javnson/GMP_H503_Peripheral_DBGer/模组介绍_v2.md

## GMP Peripheral ISO Host 工业级多总线通用转USB聚合模组

> **告别反复改版，一块板卡搞定任意现场接口！**
>
> 专为工业边缘计算、数据汇总压缩与智能网关量身打造的“万能外设桥接中枢”。

### 【行业痛点与破局之道】

在工业物联网（IIoT）与边缘数据采集项目中，现场设备协议繁多、甲方接口定义迟迟不明确、研发周期紧迫是团队常面临的困境。

**GMP Peripheral ISO Host** 应运而生——凭借强大的硬件多协议原生支持、灵活的可编程逻辑扩展、标准 Arduino 机械尺寸，以及**全套命令行（CLI）与 AI Agent Skill 工具链**，只需将其作为子卡嵌入到您的“信号汇总与压缩上传模组”中，即可轻松应对几乎所有常见工业现场与传感器接口。无论是工程师手动调试，还是交由 AI 自动巡检适配，都能以极致灵活性彻底终结接口不确定的困扰！

### 【核心产品亮点】

#### 1. 澎湃算力与工业全总线大满贯

- **高性能核心架构**：搭载全新 **高性能 ARM Cortex-M33 核心（STM32H5 系列）**，主频高达 250MHz，提供充沛的实时调度与数据预处理能力。   
- **全栈工业通信**：原生集成 **CAN / CAN-FD、RS-485、RS-232、UART** 等主流现场工业总线，板载终结电阻与工业级防护。   
- **高速板级与传感器总线**：全面覆盖 **SPI、I2C**，并前瞻性支持下一代超高速双线总线 **I3C**。   
- **运动控制与精密模拟量**：原生引出 **QEP 正交编码器接口**（带专用电平缓冲保护），以及多路 **高精度 ADC 采集** 与 **DAC 模拟输出**、通用 GPIO。   

#### 2. 独创 TPLD 硬件级可编程逻辑扩展

- **硬件级实时响应**：板载微型可编程逻辑器件（TPLD），在 MCU 之外扩展出 **7 路高灵活性可编程 I/O**。   
- **专用时钟与边沿捕获**：配备专用 SMA / RF 接口的时钟与高速边沿捕获通道（Edge Capture），轻松实现纳秒级精确时间戳标记、脉冲测频或硬件级连锁保护，让边缘采集具备硬件确定性。   

#### 3. 坚如磐石的工业级全电气隔离

- **前后端完全电气隔离**：采用专业数字隔离芯片与一体化隔离 DC-DC 稳压电源模块，将现场端（各类工业总线/模拟量）与上位机 USB 端彻底隔绝，耐受恶劣工况下的共模干扰、地环路电位差与电涌瞬变。   
- **多级 ESD 与浪涌抑制**：所有对外接口均重度布置专用瞬态抑制器（TVS/ESD Array），保障工业现场 7×24 小时连续无故障运行。   

#### 4. 全方位软件生态：GUI · 脚本级 CLI · AI Agent/Skill 深度接入

- **USB-HID 免驱架构**：下位机采用标准 USB-HID 协议通信，Windows / Linux / 工控机环境即插即用，无需安装第三方驱动。
- **专业可视化上位机**：配套专属图形化交互软件，支持一键配置总线参数、寄存器读写、波形实时监视与数据转发。
- **脚本化 CLI 命令行工具**：提供轻量高效的命令行控制台与 API，支持自动化测试脚本（Python / Shell 等）无缝调用与流水线批量操作。
- **AI-Ready / Agent Skill 原生赋能**：**配套专用的 AI Tool/Skill 接口**！可直接作为大模型智能体（AI Agent）的外设感知与执行端。开发人员只需输入自然语言（例如*“读取 RS485 地址为 0x02 的温湿度计数据并绘制波形”*或*“尝试用 500k 波特率探测 CAN 总线上有哪些在线节点”*），AI 即可调用板卡工具链自动完成总线参数协商、指令下发、通信调试、协议解析与现场部署，将调试效率推向智能化新高度！

#### 5. 标准化模块尺寸，极简嵌入

- **Arduino 标准外形尺寸**：结构紧凑，既可作为开发调试阶段的万能多功能探针，又能直接以标准子卡形态堆叠嵌入到客户的信号压缩与上网终端中，量产部署无缝衔接。   

### 【技术规格一览】

| **类别** | **规格参数** |
| --- | --- |
| **主控芯片** | STM32H503CBU6 (ARM Cortex-M33 @ 250MHz) |
| **主机接口** | Type-C USB (USB-HID 免驱，支持 USB 电气隔离) |
| **隔离性能** | 隔离 DC-DC 供电 + 高速数字隔离器全通道隔离 |
| **工业串行总线** | 1× CAN/CAN-FD、1× RS-485、1× RS-232、1× 独立 UART |
| **同步/传感器接口** | 1× 高速 SPI、1× I2C（带上拉选择）、1× I3C |
| **运动与模拟量** | 3通道 QEP 编码器输入 (A/B/Index)、多路 ADC 采样、多路 DAC 输出 |
| **可编程逻辑扩展**  | TPLD 扩展：7路自由可编程 I/O + 1路高速边沿捕获/时钟输入 (SMA接口) |
| **接口防护** | 端口全覆盖 ESD / TVS 阵列及总线级瞬变抑制保护 |
| **外形结构** | 标准 Arduino 尺寸，预留多组标准间距排针与安装定位孔 |

### 【适用场景】

- **工业边缘网关 / 数据压缩上传终端**：无需定制专用底板，快速汇总现场变频器、PLC、传感器及电表数据。
- **接口未定项目的快速验证**：为项目研发提供强大的“缓冲带”，无论客户最终敲定何种总线，底层硬件均可即刻响应。
- **实验室多功能调试神器**：工程师工作台常备的万能通信调试器、信号分析与工业总线转接利器。
- **AI 驱动的自动化调试与测试系统**：将现场总线直接接入 AI 大模型链路，由 AI 全自动完成传感器接入排查、波特率自适应嗅探与固件自动化回归测试。
