javnson/GMP_H503_Peripheral_DBGer/cpld/led_direct/configuration_summary.pdf

# Configuration Summary

# TPLD2001DGSR

# Version: 1.8.0+1529

# Date Created: 10/12/2026

## This document is to provide information related to the design. The information available in this document is an image of the schematic, an estimation of power consumed, an

input and output table, a set of tables indicating how the blocks are configured,

## frequencies propogating through the device, and the hex code that was pushed into registers. For general device information such as electrical characteristics refer to the

datasheet.

## Summary

## Schematic Diagram

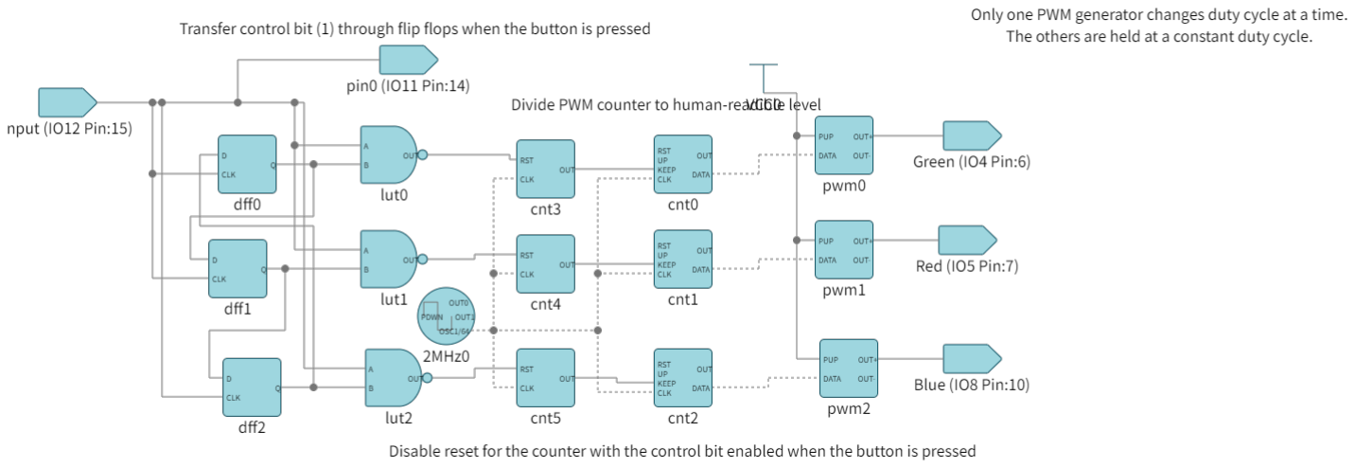
[picture p1: figure]

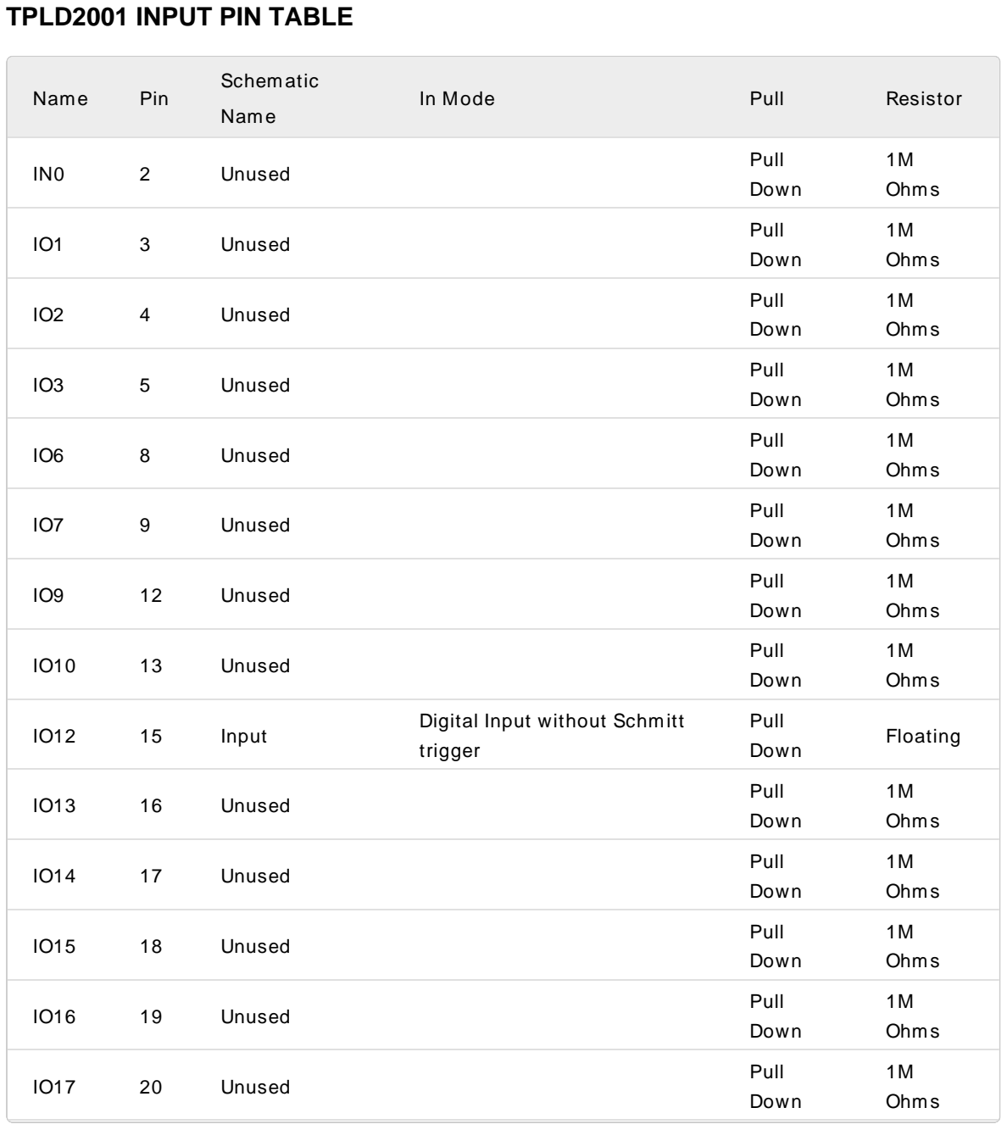
[picture p2: figure]
Name; Pin; Schematic; In Mode; Pull; Resistor; Unused; Pull Down; 1M Ohms; Input; Digital Input without Schmitt trigger; Floating; TPLD2001 INPUT PIN TABLE

## TPLD2001 OUTPUT PIN TABLE

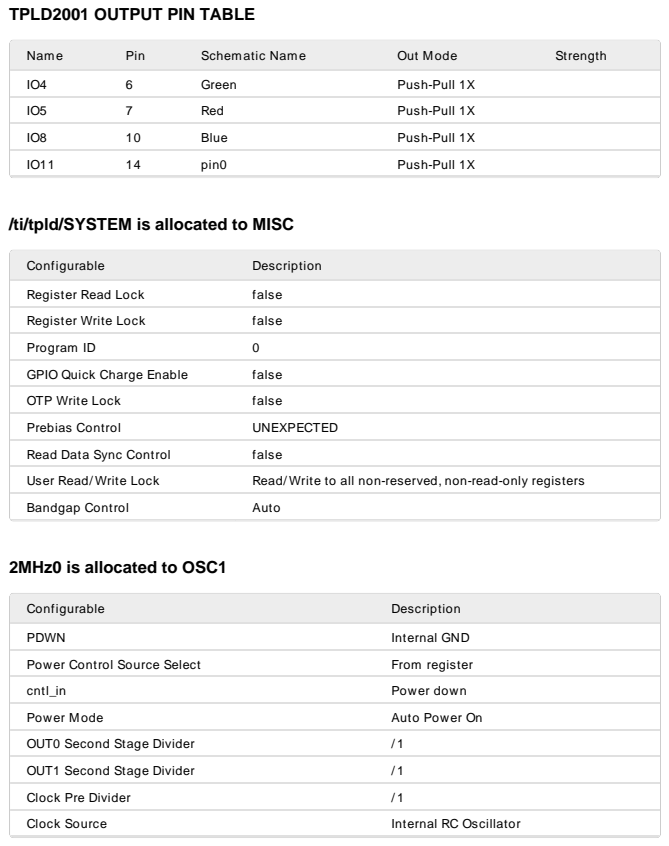
[picture p3: page 4]

/ti/tpld/SYSTEM is allocated to MISC

Configurable | Description
IN | pwm2.OUT0
in_ctl | Digital Input without Schmitt trigger
Output Mode | Push-Pull 1X
Pull | Pull Down
Pull Up/ Down Resistor Value | Floating
Configurable | Description
CLK | 2MHz0.OSC1/ 64
IN | Internal GND
KEEP | cnt3
UP | Internal GND
Initial Value | Bypass initial
Output Polarity | Non-inverted
Control Data | 255
KEEP Sync Bypass | 2-DFF sync
RST Sync Bypass | 2-DFF sync
UP Sync Bypass | 2-DFF sync

## Blue is allocated to IO8

## cnt0 is allocated to CNT6_FSM0

Configurable | Description
CLK | 2MHz0.OSC1/ 64
IN | Internal GND
KEEP | cnt4
UP | Internal GND
Initial Value | Bypass initial
Output Polarity | Non-inverted
Control Data | 255
KEEP Sync Bypass | 2-DFF sync
RST Sync Bypass | 2-DFF sync
UP Sync Bypass | 2-DFF sync
Configurable | Description
CLK | 2MHz0.OSC1/ 64
IN | Internal GND
KEEP | cnt5
UP | Internal GND
Initial Value | Bypass initial
Output Polarity | Non-inverted
Control Data | 255
KEEP Sync Bypass | 2-DFF sync
RST Sync Bypass | 2-DFF sync
UP Sync Bypass | 2-DFF sync

## cnt1 is allocated to CNT7_FSM1

## cnt2 is allocated to CNT8_FSM2

## cnt3 is allocated to LUT3_10

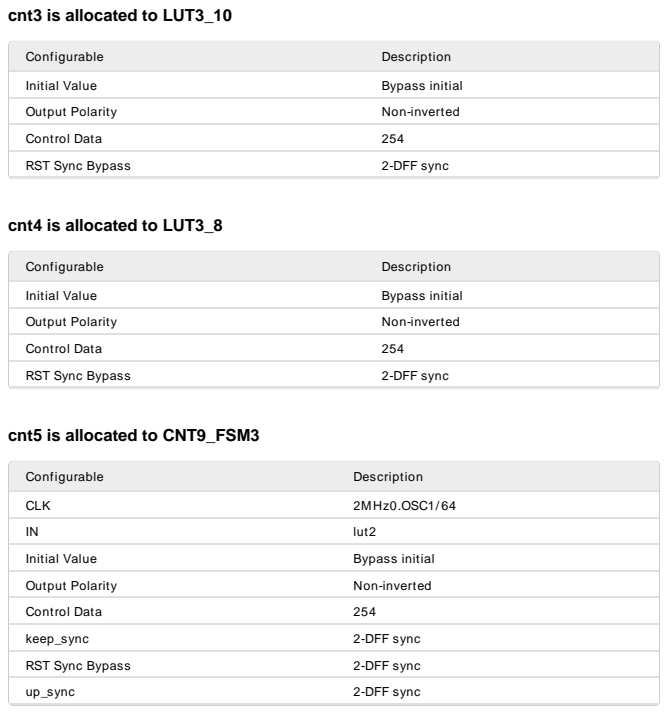
[picture p4: page 7]

## dff0 is allocated to LUT2_2

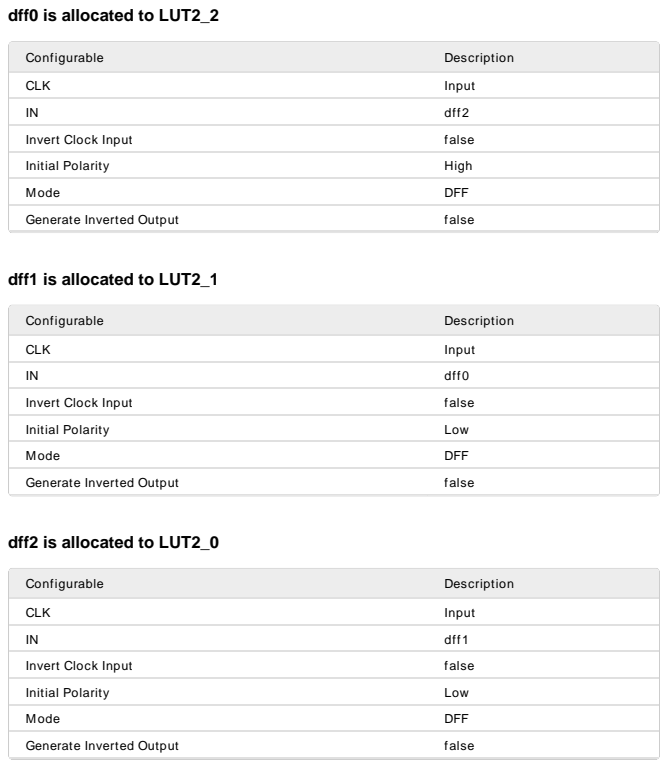
[picture p5: page 8]

## Green is allocated to IO4

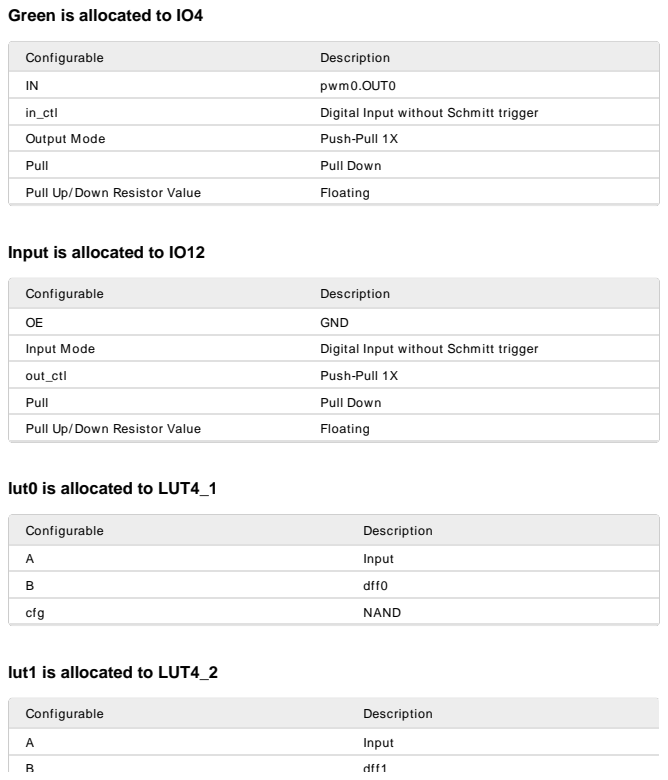
[picture p6: page 9]

Input is allocated to IO12

## lut2 is allocated to LUT4_3

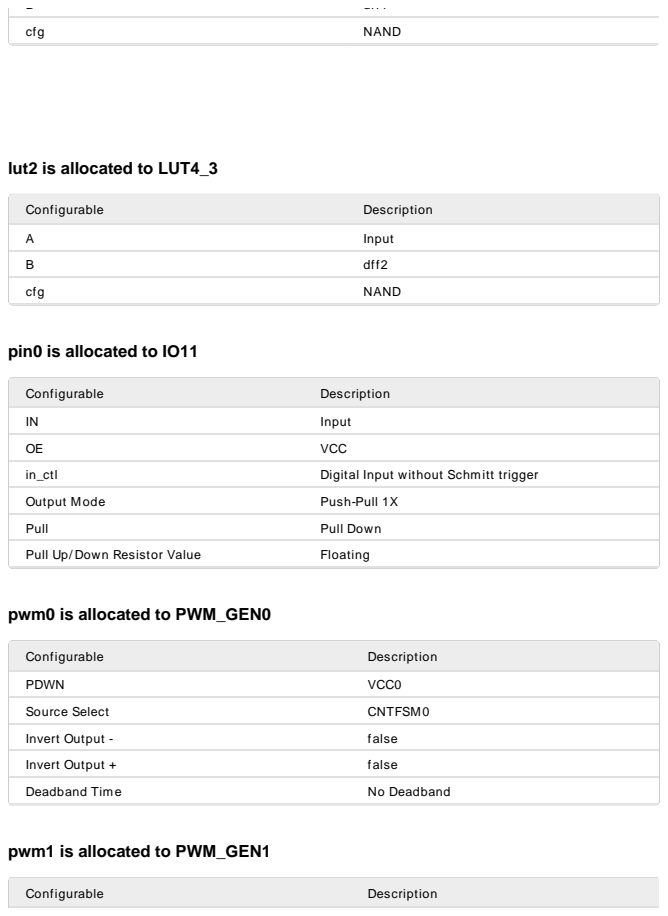
[picture p7: page 10]

## pwm2 is allocated to PWM_GEN2

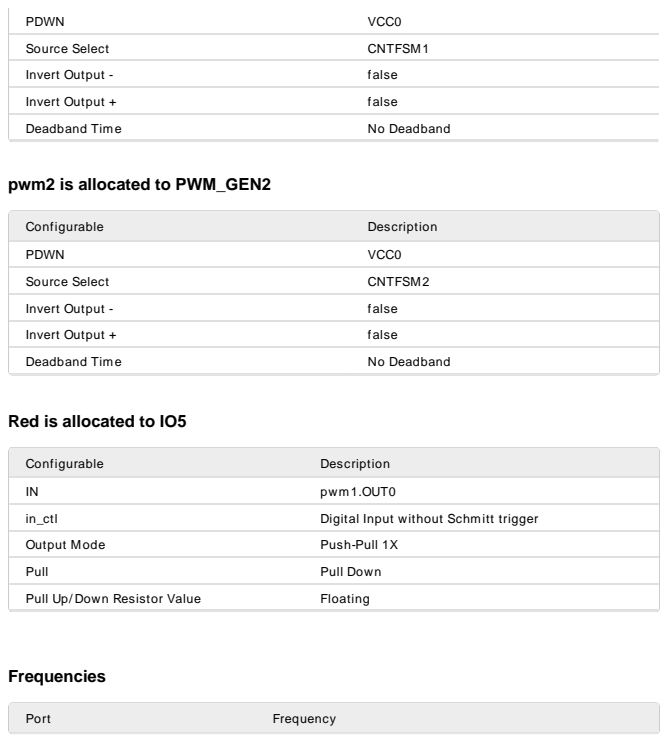
[picture p8: page 11]

Red is allocated to IO5

## :10020000000000000000484a00004c0000000d7f86 :1002100000000000000000000000000d140d150d90

:1002200013000000000000000000000000000000bd :10023000000000000000000000000000002500009b

## :1002400000000024000000000000000d1500000d5d

:100250001400000d1300000000000000000000006c :100260000000000000000000000000000000000090 :10027000000000000000000000000000000000215f

## :100280000000001f0000004700260000007f7f7f67

:100290000000000000000000000000000000000060 :1002a0000000000000000000000000000000000050 :1002b0000000000000000000000000000000000040 :1002c0000000000000000000000000000000000030 :1002d0000000000000000000000000000000000020 :1002e0000000000000000000000000000000000010 :1002f0000000000000000000000000000000000000 :100300003030303080803030803030000030303060 :100310003030000000000000000000000000000080 :1003200000000000070000000000040000000000c5 :1003300000000000000000000000000000000000c0 :1003400000000000000077777777777700000000e6

## :10035000000000000000f000000000f0000000fec2

:100360004f00010000f00000000000000000000050

## :10037000000000fe004f0001000000f00000ff4cf7 :1003800000ff4c00ff4c00fe4f0000000000240069

:100390000000000000000000000000000000000060 :1003a0000000000000000000000000000000000050 :1003b0000000000000000000000000000000000040 :1003c0000000000000000000000000000000000030 :1003d0000000000000000000000000000000000020 :1003e0000000000000000000000000000000000010

## :1003f0000000030000000000110000000000d7eb2a :00000001FF

## OTP Map in Intel Hex Format
