javnson/GMP_H503_Peripheral_DBGer/hardware/PeripheralHost.pdf

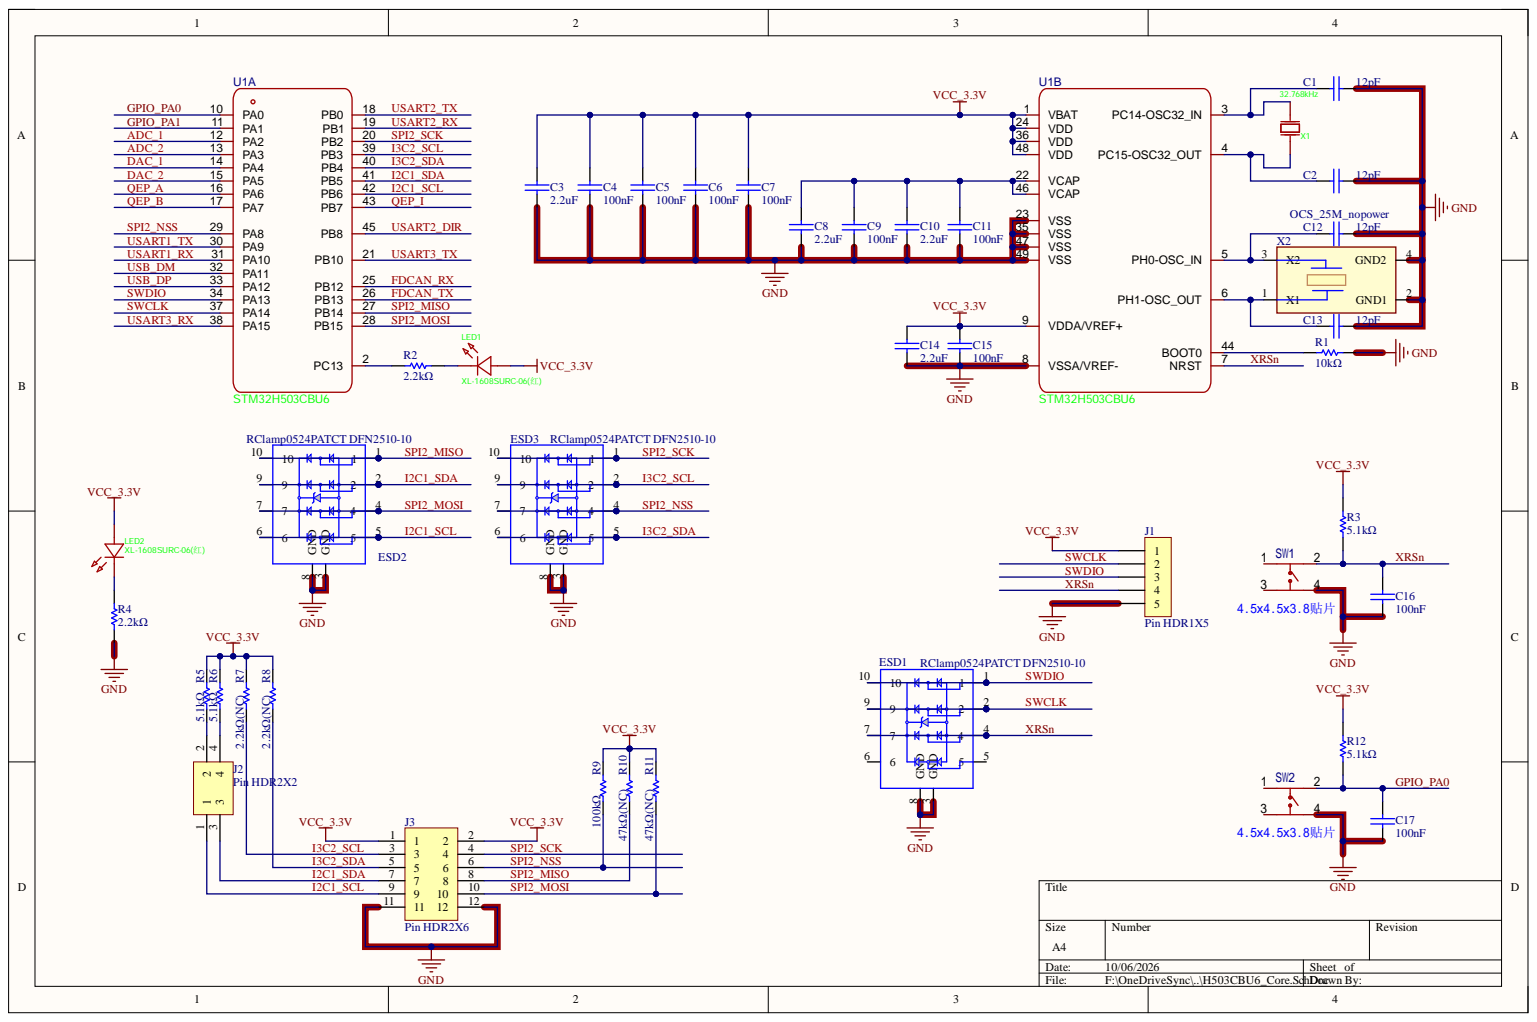
[picture p9: page 1]

VCC_ _MIS O

I3C2 | 3 | 4 6 8 | SPI2
I3C2 _ S D A | 5

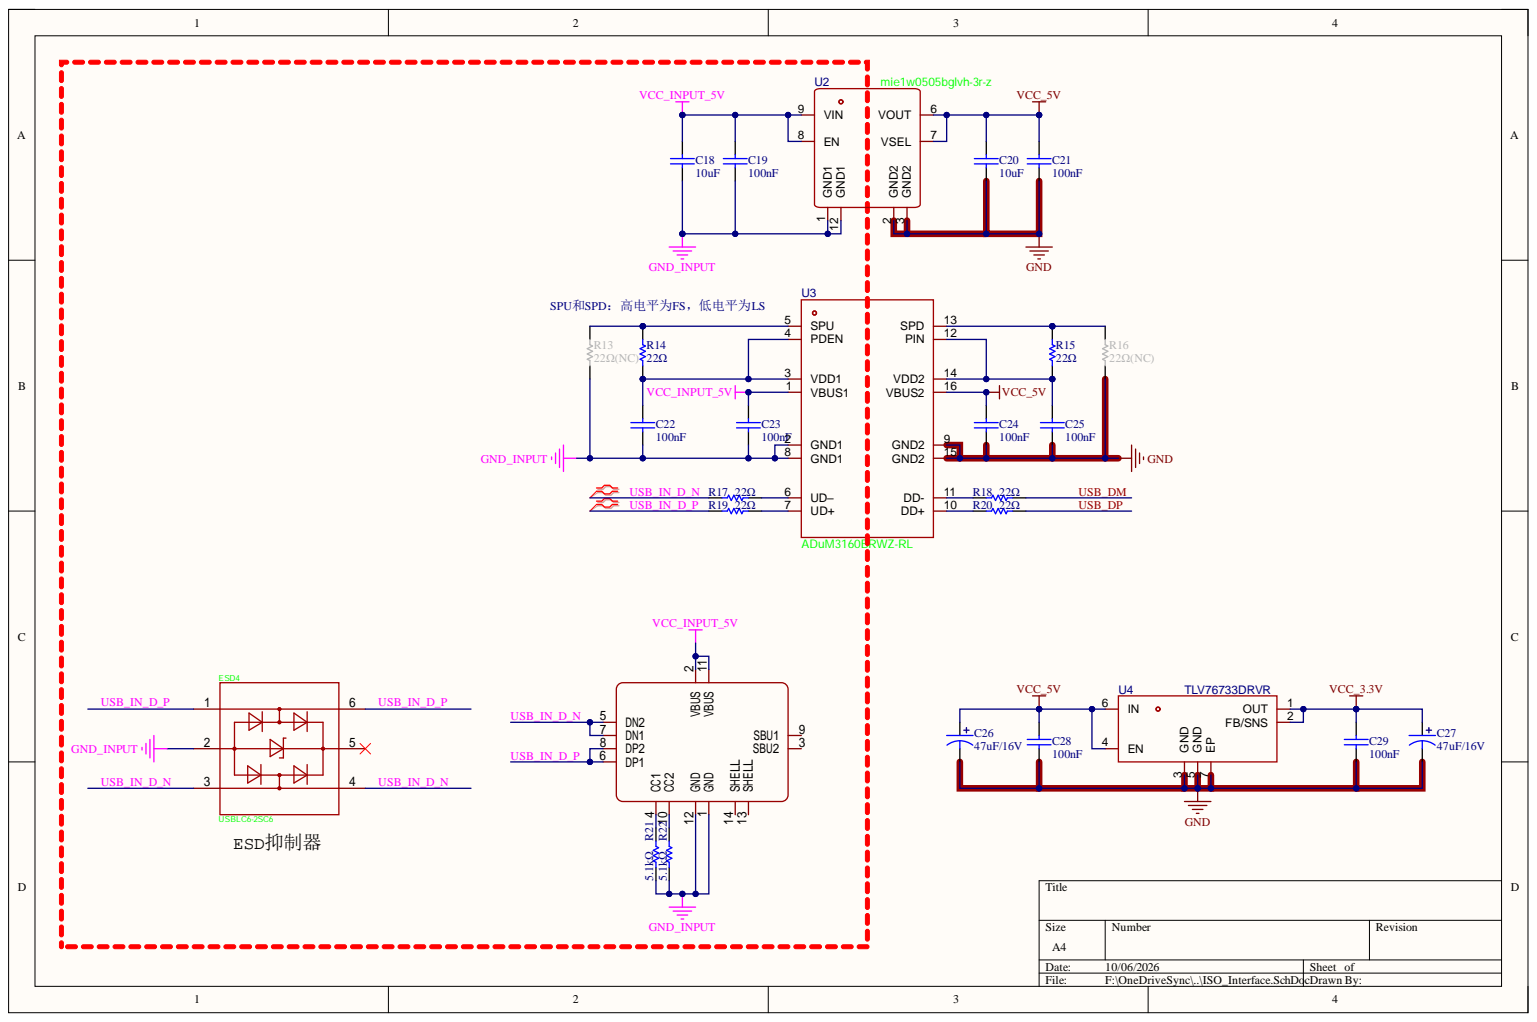
[picture p10: page 2]

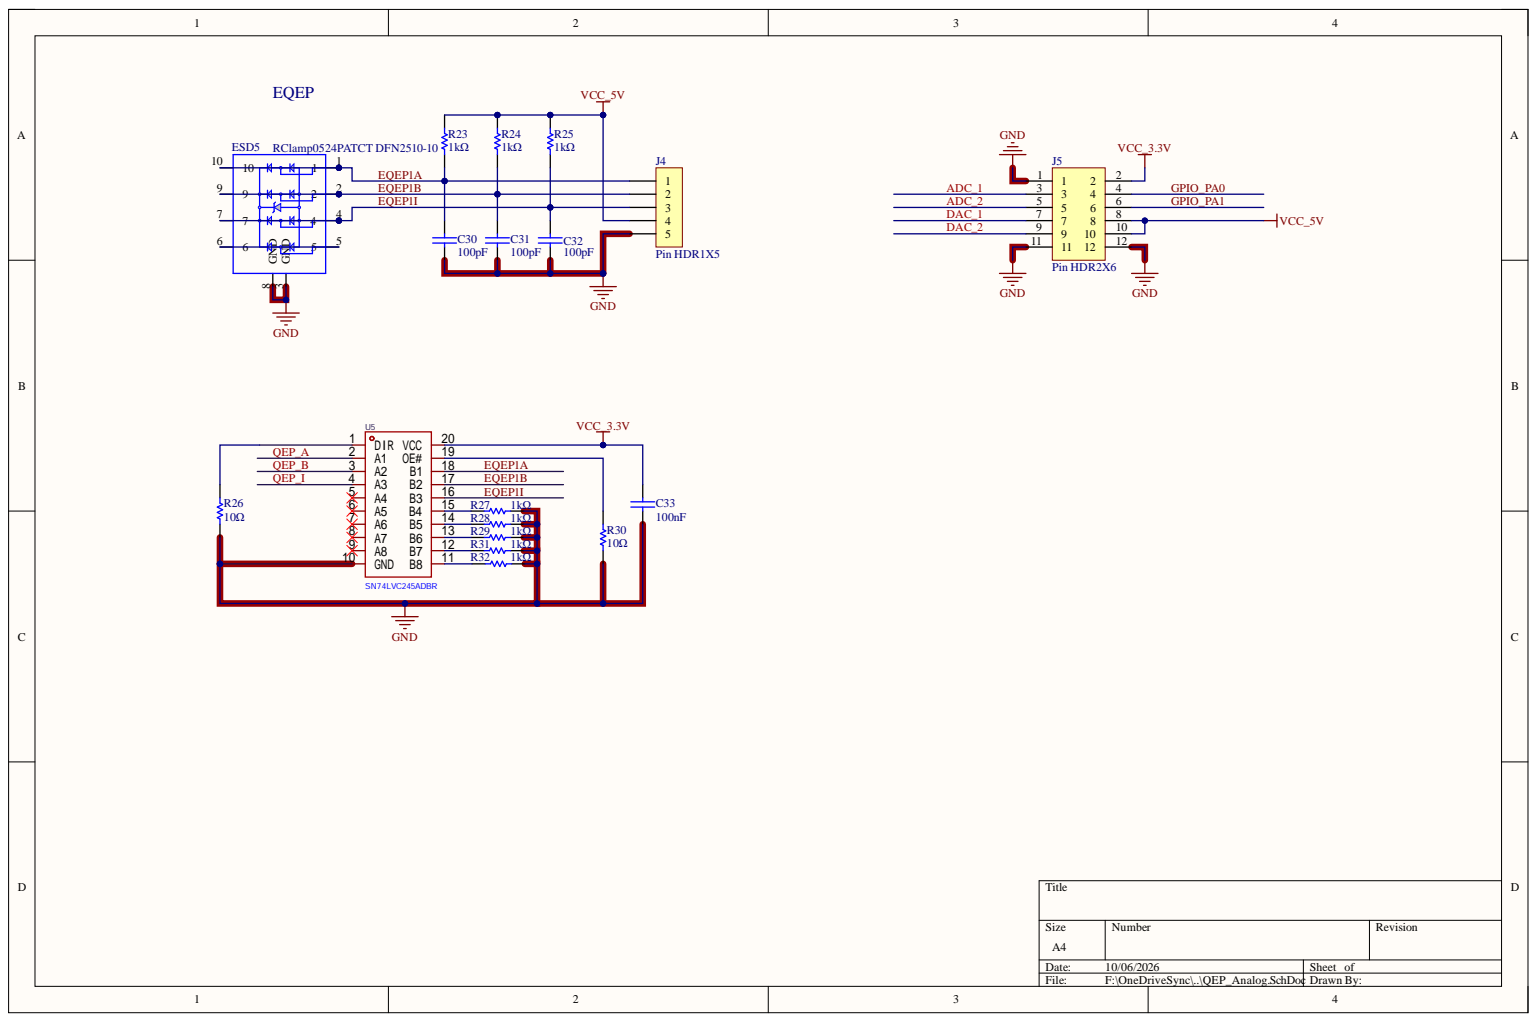
[picture p11: page 3]

Q E P_A
Q EP_ B | | E Q E P 1 A E Q E P 1 B E Q E P 1 I R2 7 1 k Ω

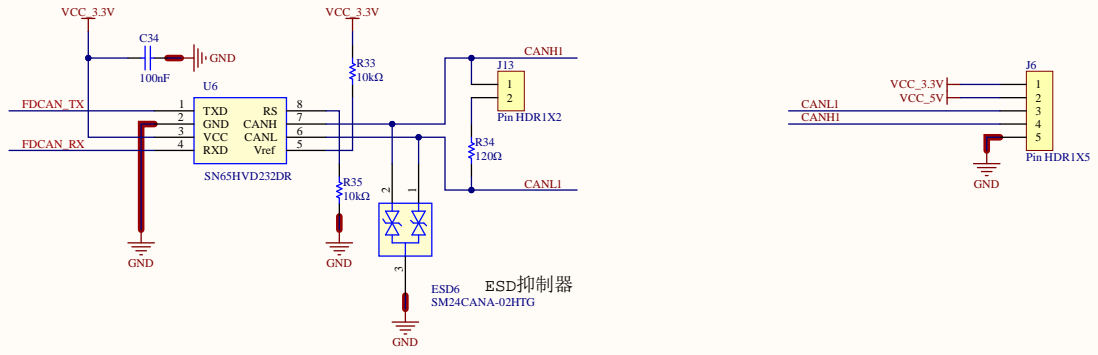
[picture p12: page 4]

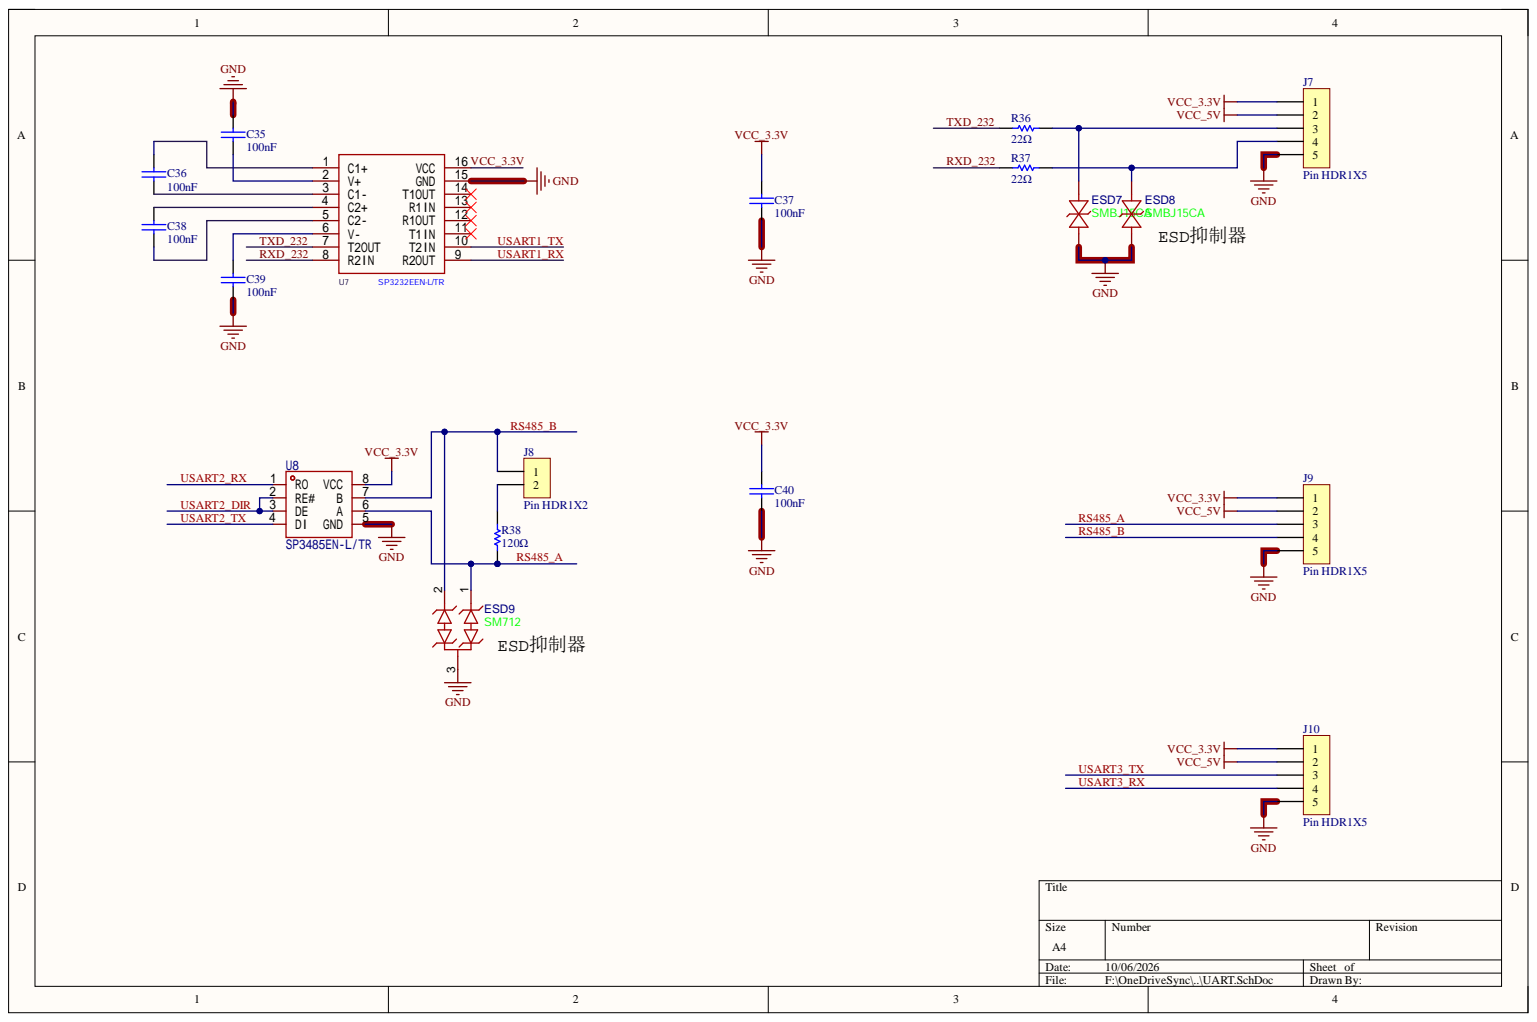
[picture p13: page 5]

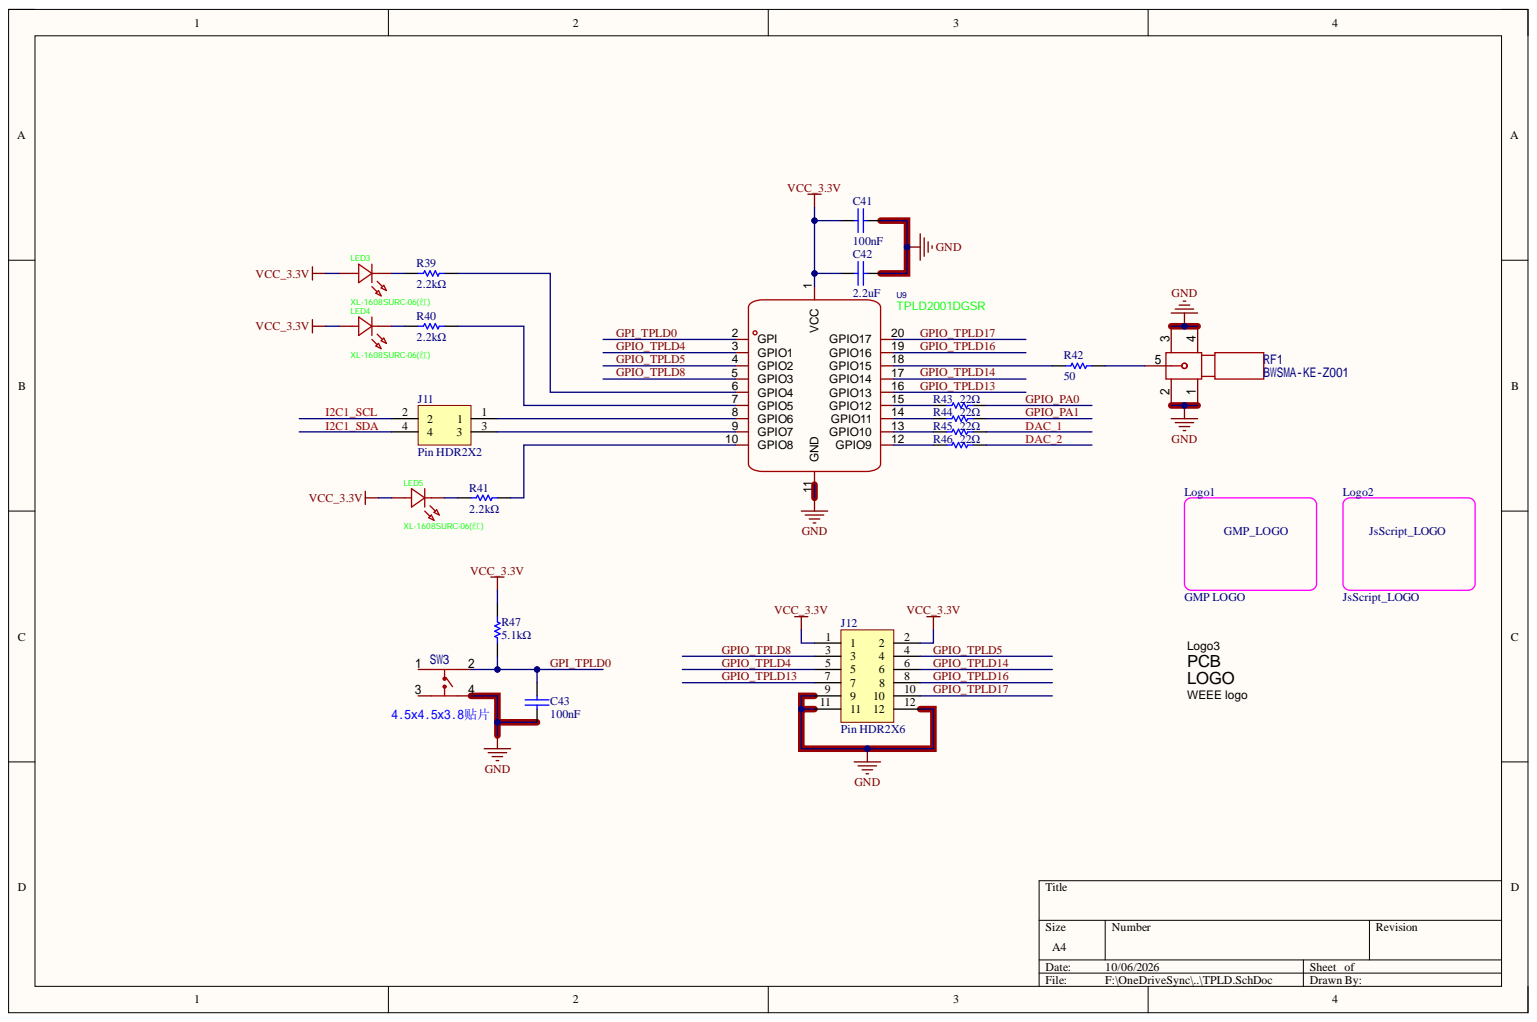
[picture p14: page 6]

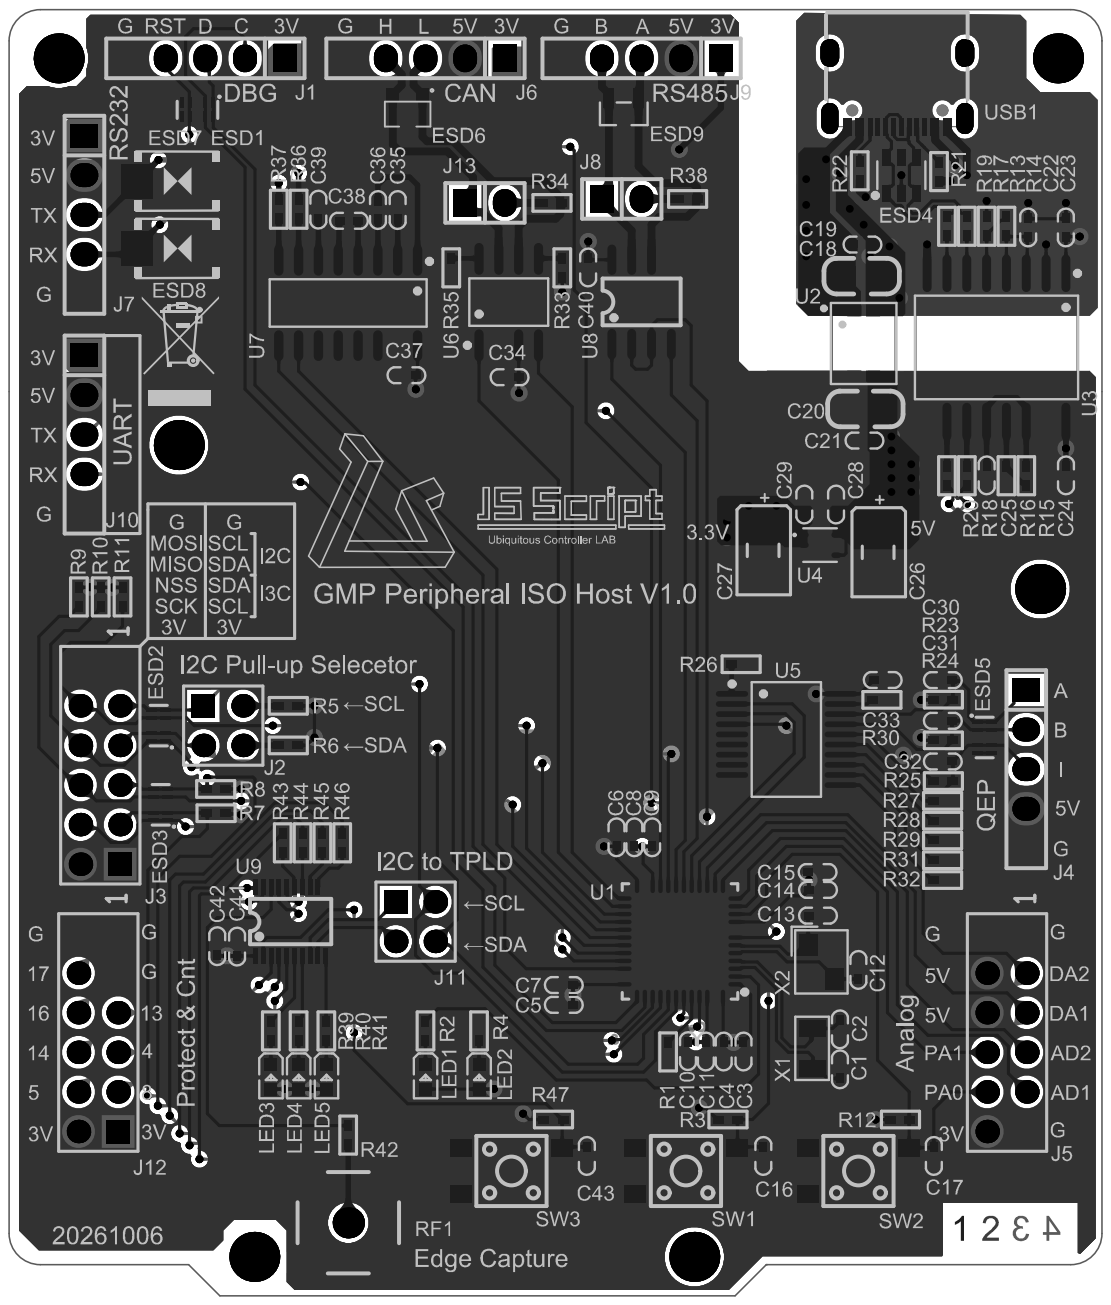
[picture p15: page 7]

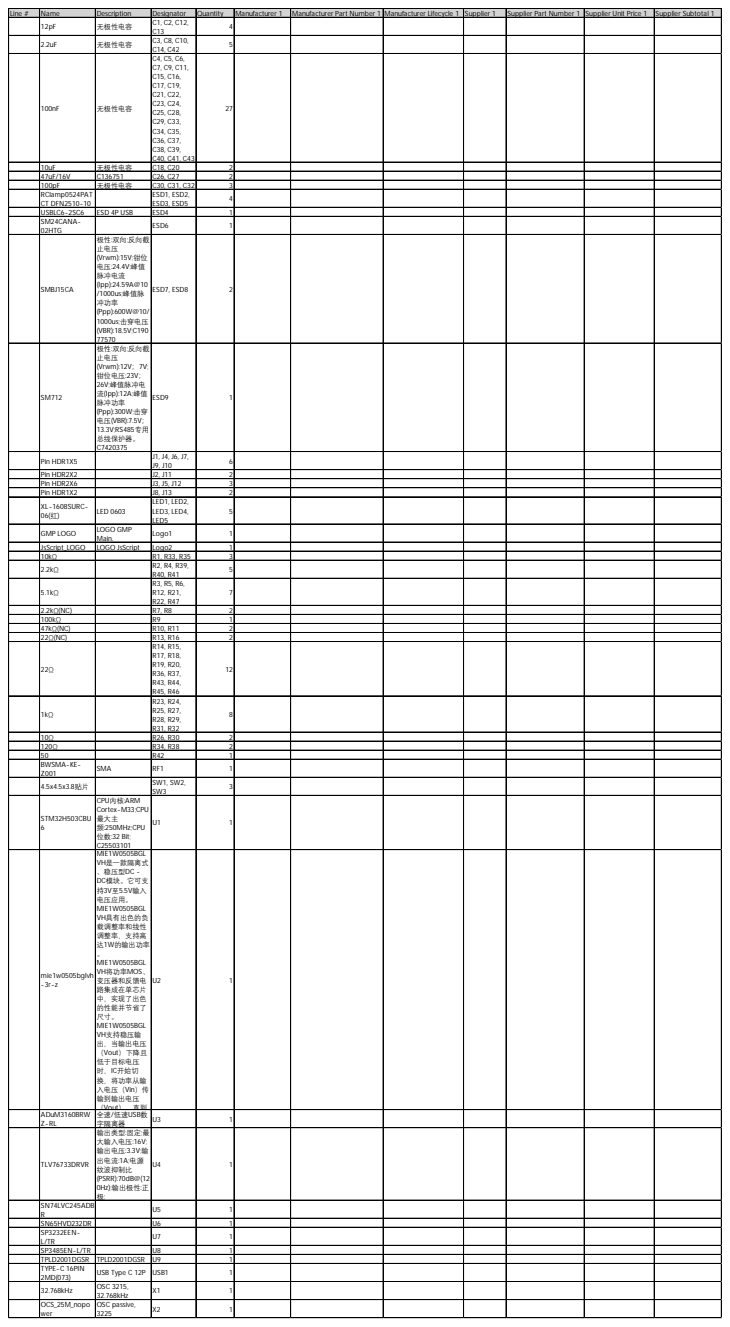
[picture p16: page 8]

Line # | Name | Description | Designator | Quantity | Manufacturer 1 | Manufacturer Part Number 1 | Manufacturer Lifecycle 1 | Supplier 1 | Supplier Part Number 1 | Supplier Unit Price 1 | Supplier Subtotal 1

12pF | 无极性电容 | C1, C2, C12, C13 | | 4

2.2uF | 无极性电容 | C3, C8, C10, C14, C42 | | 5

100nF | 无极性电容 | C4, C5, C6, C7, C9, C11, C15, C16, C17, C19, C21, C22, C23, C24, C25, C28, C29, C33, C34, C35, C36, C37, C38, C39, C40, C41, C43 | 27

10uF | 无极性电容 | C18, C20 | | 2
47uF/16V | C136751 | C26, C27 | | 2
100pF | 无极性电容 | C30, C31, C32 | | 3
RClamp0524PAT CT DFN2510-10 | | ESD1, ESD2, ESD3, ESD5 | | 4

USBLC6-2SC6 | ESD 4P USB | ESD4 | | 1
SM24CANA-02HTG | | ESD6 | | 1

SMBJ15CA | 极性:双向;反向截 止电压 (Vrwm):15V;钳位 电压:24.4V;峰值 脉冲电流 (Ipp):24.59A@10 /1000us;峰值脉 冲功率 (Ppp):600W@10/ 1000us;击穿电压 (VBR):18.5V;C190 77570 | ESD7, ESD8 | | 2

SM712 | 极性:双向;反向截 止电压 (Vrwm):12V；7V; 钳位电压:23V； 26V;峰值脉冲电 流(Ipp):12A;峰值 脉冲功率 (Ppp):300W;击穿 电压(VBR):7.5V； 13.3V;RS485专用 总线保护器。 C7420375 | ESD9 | | 1

Pin HDR1X5 | | J1, J4, J6, J7, J9, J10 | | 6

Pin HDR2X2 | | J2, J11 | | 2
Pin HDR2X6 | | J3, J5, J12 | | 3
Pin HDR1X2 | | J8, J13 | | 2
XL-1608SURC-06(红) | LED 0603 | LED1, LED2, LED3, LED4, LED5 | | 5

GMP LOGO | LOGO GMP Main. | Logo1 | | 1

JsScript_LOGO | LOGO JsScript | Logo2 | | 1
10kΩ | | R1, R33, R35 | | 3
2.2kΩ | | R2, R4, R39, R40, R41 | | 5

2.2kΩ(NC) | | R7, R8 | | 2
100kΩ | | R9 | | 1
47kΩ(NC) | | R10, R11 | | 2
22Ω(NC) | | R13, R16 | | 2
22Ω | | R14, R15, R17, R18, R19, R20, R36, R37, R43, R44, R45, R46 | 12

10Ω | | R26, R30 | | 2
120Ω | | R34, R38 | | 2
50 | | R42 | | 1
BWSMA-KE-Z001 | SMA | RF1 | | 1

STM32H503CBU 6 | CPU内核:ARM Cortex-M33;CPU 最大主 频:250MHz;CPU 位数:32 Bit; C25503101 | U1 | | 1

mie1w0505bglvh -3r-z | MIE1W0505BGL VH是一款隔离式 、稳压型DC -DC模块。它可支 持3V至5.5V输入 电压应用。 MIE1W0505BGL VH具有出色的负 载调整率和线性 调整率，支持高 达1W的输出功率 。 MIE1W0505BGL VH将功率MOS、 变压器和反馈电 路集成在单芯片 中，实现了出色 的性能并节省了 尺寸。 MIE1W0505BGL VH支持稳压输 出，当输出电压 （Vout）下降且 低于目标电压 时，IC开始切 换，将功率从输 入电压（Vin）传 输到输出电压 （Vout），直到 | U2 | | 1

ADuM3160BRW Z-RL | 全速/低速USB数 字隔离器 | U3 | | 1

TLV76733DRVR | 输出类型:固定;最 大输入电压:16V; 输出电压:3.3V;输 出电流:1A;电源 纹波抑制比 (PSRR):70dB@(12 0Hz);输出极性:正 极; | U4 | | 1

SN74LVC245ADB R | | U5 | | 1

SN65HVD232DR | | U6 | | 1
SP3232EEN-L/TR | | U7 | | 1

SP3485EN-L/TR | | U8 | | 1
TPLD2001DGSR | TPLD2001DGSR | U9 | | 1
TYPE-C 16PIN 2MD(073) | USB Type C 12P | USB1 | | 1

32.768kHz | OSC 3215, 32.768kHz | X1 | | 1

OCS_25M_nopo wer | OSC passive, 3225 | X2 | | 1
