javnson/GMP_H503_Peripheral_DBGer/H503_Peripheral_DBGer/Core/Src/main.c

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
/* Includes ------------------------------------------------------------------*/
#include "main.h"

/* USER CODE BEGIN Includes */
#include "tpld2001.h"
#ifdef H503_BRIDGE
#include "bridge.h"
#include "bridge_metrics.h"
#endif

/* USER CODE END Includes */


DAC_HandleTypeDef hdac1;

DTS_HandleTypeDef hdts;

FDCAN_HandleTypeDef hfdcan1;

I2C_HandleTypeDef hi2c1;

I3C_HandleTypeDef hi3c2;

RTC_HandleTypeDef hrtc;

SPI_HandleTypeDef hspi2;

TIM_HandleTypeDef htim1;
TIM_HandleTypeDef htim2;
TIM_HandleTypeDef htim3;

UART_HandleTypeDef huart1;

PCD_HandleTypeDef hpcd_USB_DRD_FS;

/* USER CODE BEGIN PV */
volatile TPLD_Status tpld_status = TPLD_NO_DEVICE;
volatile uint8_t tpld_i2c_address = 0;
volatile uint8_t tpld_loopback_ok = 0;
volatile uint32_t tpld_loopback_passes = 0;
volatile uint32_t tpld_loopback_failures = 0;
#ifdef TPLD_PULSE_DISTRIBUTOR
volatile uint8_t tpld_phase_abc = 0;
volatile uint32_t tpld_phase_passes = 0;
volatile uint32_t tpld_phase_failures = 0;
#endif

/* USER CODE END PV */

void SystemClock_Config(void);
static void MPU_Config(void);
static void MX_GPIO_Init(void);
static void MX_DAC1_Init(void);
static void MX_DTS_Init(void);
static void MX_FDCAN1_Init(void);
static void MX_I2C1_Init(void);
static void MX_I3C2_Init(void);
static void MX_ICACHE_Init(void);
static void MX_RTC_Init(void);
static void MX_SPI2_Init(void);
static void MX_TIM1_Init(void);
static void MX_TIM3_Init(void);
static void MX_USART1_UART_Init(void);
static void MX_USB_PCD_Init(void);
/* USER CODE BEGIN 0 */
static void TPLD_Pins_Safe_Init(void)
{
  GPIO_InitTypeDef gpio = {0};
  __HAL_RCC_GPIOA_CLK_ENABLE();
  gpio.Pin = GPIO_PIN_0 | GPIO_PIN_1;
#ifdef TPLD_PULSE_DISTRIBUTOR
  /* PA4/PA5 share the DAC_1/DAC_2 nets with TPLD IO10/IO9. */
  gpio.Pin |= GPIO_PIN_4 | GPIO_PIN_5;
#endif
  gpio.Mode = GPIO_MODE_INPUT;
  gpio.Pull = GPIO_NOPULL;
  HAL_GPIO_Init(GPIOA, &gpio);
}

static HAL_StatusTypeDef TPLD_Start_10Hz(void)
{
  TIM_OC_InitTypeDef channel = {0};
  GPIO_InitTypeDef gpio = {0};

  /* APB1 timer clock is 250 MHz: 250 MHz / 25000 / 1000 = 10 Hz. */
  __HAL_RCC_TIM2_CLK_ENABLE();
  htim2.Instance = TIM2;
  htim2.Init.Prescaler = 24999U;
  htim2.Init.CounterMode = TIM_COUNTERMODE_UP;
  htim2.Init.Period = 999U;
  htim2.Init.ClockDivision = TIM_CLOCKDIVISION_DIV1;
  htim2.Init.AutoReloadPreload = TIM_AUTORELOAD_PRELOAD_DISABLE;
  if (HAL_TIM_PWM_Init(&htim2) != HAL_OK) return HAL_ERROR;

  channel.OCMode = TIM_OCMODE_PWM1;
  channel.Pulse = 500U;
  channel.OCPolarity = TIM_OCPOLARITY_HIGH;
  channel.OCFastMode = TIM_OCFAST_DISABLE;
  if (HAL_TIM_PWM_ConfigChannel(&htim2, &channel, TIM_CHANNEL_1) != HAL_OK)
    return HAL_ERROR;

  gpio.Pin = GPIO_PIN_0;
  /* SW2 can pull PA0 to ground; use the board's 5.1 kOhm pull-up. */
  gpio.Mode = GPIO_MODE_AF_OD;
  gpio.Pull = GPIO_NOPULL;
  gpio.Speed = GPIO_SPEED_FREQ_LOW;
  gpio.Alternate = GPIO_AF1_TIM2;
  HAL_GPIO_Init(GPIOA, &gpio);
  return HAL_TIM_PWM_Start(&htim2, TIM_CHANNEL_1);
}

#ifdef TPLD_PULSE_DISTRIBUTOR
static uint8_t TPLD_Read_Phase(void)
{
  uint8_t phase = 0;
  if (HAL_GPIO_ReadPin(GPIOA, GPIO_PIN_1) == GPIO_PIN_SET) phase |= 4U;
  if (HAL_GPIO_ReadPin(GPIOA, GPIO_PIN_4) == GPIO_PIN_SET) phase |= 2U;
  if (HAL_GPIO_ReadPin(GPIOA, GPIO_PIN_5) == GPIO_PIN_SET) phase |= 1U;
  return phase;
}

static int8_t TPLD_Phase_Index(uint8_t phase)
{
  static const uint8_t ring[6] = {4U, 6U, 2U, 3U, 1U, 5U};
  for (int8_t i = 0; i < 6; ++i) {
    if (ring[i] == phase) return i;
  }
  return -1;
}
#endif

/* USER CODE END 0 */

/**
  * @brief  The application entry point.
  * @retval int
  */
int main(void)
{

  /* USER CODE BEGIN 1 */
  uint8_t found_address = 0;

  /* USER CODE END 1 */

  /* MCU Configuration--------------------------------------------------------*/

  /* MPU Configuration--------------------------------------------------------*/
  MPU_Config();

  /* Reset of all peripherals, Initializes the Flash interface and the Systick. */
  HAL_Init();

  /* Configure the system clock */
  SystemClock_Config();

  /* The software I2C programmer uses GPIO only. */
  MX_GPIO_Init();
  /* USER CODE BEGIN 2 */
#ifdef H503_BRIDGE
  Bridge_Init();
#else
  TPLD_Pins_Safe_Init();
  tpld_status = TPLD2001_Load(&found_address);
  tpld_i2c_address = found_address;
  if (tpld_status == TPLD_OK && TPLD_Start_10Hz() != HAL_OK)
    tpld_status = TPLD_PWM_FAILED;
#endif

  /* USER CODE END 2 */

  /* Infinite loop */
  /* USER CODE BEGIN WHILE */
#ifdef TPLD_PULSE_DISTRIBUTOR
  uint8_t sampled_window = 0;
  int8_t previous_phase_index = -1;
#endif
  while (1)
  {
#ifdef H503_BRIDGE
    BridgeMetrics_PollBegin();
    Bridge_Poll();
    BridgeMetrics_PollEnd();
    BridgeMetrics_Idle();
#else
    if (tpld_status == TPLD_OK) {
      uint32_t counter = __HAL_TIM_GET_COUNTER(&htim2);
#ifdef TPLD_PULSE_DISTRIBUTOR
      /* Observe one settled sample per 10 Hz clock cycle. */
      if (counter < 200U) sampled_window = 0;
      if (counter >= 200U && counter < 300U && !sampled_window) {
        int8_t phase_index;
        sampled_window = 1;
        tpld_phase_abc = TPLD_Read_Phase();
        phase_index = TPLD_Phase_Index(tpld_phase_abc);
        if (phase_index >= 0 &&
            (previous_phase_index < 0 ||
             phase_index == (previous_phase_index + 1) % 6 ||
             phase_index == (previous_phase_index + 5) % 6)) {
          ++tpld_phase_passes;
        } else {
          ++tpld_phase_failures;
        }
        previous_phase_index = phase_index;
      }
#else
      /* Sample PA1 away from each PWM edge. IO12 -> IO11 is a passthrough. */
      if ((counter >= 100U && counter < 400U) ||
          (counter >= 600U && counter < 900U)) {
        GPIO_PinState expected = counter < 500U ? GPIO_PIN_SET : GPIO_PIN_RESET;
        tpld_loopback_ok = (HAL_GPIO_ReadPin(GPIOA, GPIO_PIN_1) == expected);
        if (tpld_loopback_ok) ++tpld_loopback_passes;
        else ++tpld_loopback_failures;
      }
#endif
    }
    HAL_Delay(1);
#endif
    /* USER CODE END WHILE */

    /* USER CODE BEGIN 3 */
  }
  /* USER CODE END 3 */
}

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
 /* MPU Configuration */

void MPU_Config(void)
{
  MPU_Region_InitTypeDef MPU_InitStruct = {0};
  MPU_Attributes_InitTypeDef MPU_AttributesInit = {0};

  /* Disables the MPU */
  HAL_MPU_Disable();

  /** Initializes and configures the Region 0 and the memory to be protected
  */
  MPU_InitStruct.Enable = MPU_REGION_ENABLE;
  MPU_InitStruct.Number = MPU_REGION_NUMBER0;
  MPU_InitStruct.BaseAddress = 0x08FFF000;
  MPU_InitStruct.LimitAddress = 0x08FFFFFF;
  MPU_InitStruct.AttributesIndex = MPU_ATTRIBUTES_NUMBER0;
  MPU_InitStruct.AccessPermission = MPU_REGION_ALL_RO;
  MPU_InitStruct.DisableExec = MPU_INSTRUCTION_ACCESS_DISABLE;
  MPU_InitStruct.IsShareable = MPU_ACCESS_NOT_SHAREABLE;

  HAL_MPU_ConfigRegion(&MPU_InitStruct);

  /** Initializes and configures the Attribute 0 and the memory to be protected
  */
  MPU_AttributesInit.Number = MPU_ATTRIBUTES_NUMBER0;
  MPU_AttributesInit.Attributes = INNER_OUTER(MPU_NOT_CACHEABLE);

  HAL_MPU_ConfigMemoryAttributes(&MPU_AttributesInit);
  /* Enables the MPU */
  HAL_MPU_Enable(MPU_PRIVILEGED_DEFAULT);

}

/**
  * @brief  This function is executed in case of error occurrence.
  * @retval None
  */
void Error_Handler(void)
{
  /* USER CODE BEGIN Error_Handler_Debug */
  /* User can add his own implementation to report the HAL error return state */
  __disable_irq();
  while (1)
  {
  }
  /* USER CODE END Error_Handler_Debug */
}
#ifdef USE_FULL_ASSERT
/**
  * @brief  Reports the name of the source file and the source line number
  *         where the assert_param error has occurred.
  * @param  file: pointer to the source file name
  * @param  line: assert_param error line source number
  * @retval None
  */
void assert_failed(uint8_t *file, uint32_t line)
{
  /* USER CODE BEGIN 6 */
  /* User can add his own implementation to report the file name and line number,
     ex: printf("Wrong parameters value: file %s on line %d\r\n", file, line) */
  /* USER CODE END 6 */
}
#endif /* USE_FULL_ASSERT */
