javnson/GMP_H503_Peripheral_DBGer/H503_Peripheral_DBGer/H503_Peripheral_DBGer.ioc

Mcu.UserName=STM32H503CBUx
PA10.Signal=USART1_RX
PA11.Signal=USB_DM
PA12.Signal=USB_DP
PA13(JTMS/SWDIO).Signal=DEBUG_JTMS-SWDIO
PA14(JTCK/SWCLK).Signal=DEBUG_JTCK-SWCLK
PA15(JTDI).Signal=USART3_RX
PA2.Signal=ADCx_INP14
PA3.Signal=ADCx_INP15
PA4.Signal=COMP_DAC11_group
PA5.Signal=COMP_DAC12_group
PA6.Signal=S_TIM3_CH1
PA7.Signal=S_TIM3_CH2
PA8.Signal=SPI2_NSS
PA9.Signal=USART1_TX
PB0.Signal=USART2_TX
PB1.Signal=USART2_RX
PB10.Signal=USART3_TX
PB12.Signal=FDCAN1_RX
PB13.Signal=FDCAN1_TX
PB14.Signal=SPI2_MISO
PB15.Signal=SPI2_MOSI
PB2.Signal=SPI2_SCK
PB3(JTDO/TRACESWO).Signal=I3C2_SCL
PB4(NJTRST).Signal=I3C2_SDA
PB5.Signal=I2C1_SDA
PB6.Signal=I2C1_SCL
PB7.Signal=S_TIM3_ETR
PB8.Signal=GPIO_Output
PC14-OSC32_IN(OSC32_IN).Signal=RCC_OSC32_IN
PC15-OSC32_OUT(OSC32_OUT).Signal=RCC_OSC32_OUT
PH0-OSC_IN(PH0).Signal=RCC_OSC_IN
PH1-OSC_OUT(PH1).Signal=RCC_OSC_OUT
