javnson/GMP_H503_Peripheral_DBGer/(notices)

Notices in the files:
H503_Peripheral_DBGer/Core/Src/main.c:
Copyright (c) 2026 STMicroelectronics.
All rights reserved.
This software is licensed under terms that can be found in the LICENSE file
